bikerglen/poe-ckcb4-floodlight/README.md

# poe-ckcb4-floodlight
Power over Ethernet and Art-Net control for a Color Kinetics Colorburst 4 RGB LED floodlight
